hhautomatizacion/esclavochallenge/README.md

<br/>
<p align="center">
  
</p>
<br/>

# EsclavoChallenge

## Fecha
* 2013

## Descripcion del proyecto
* Esclavo para monitoreo de secadora challenge

## Herramientas utilizadas
* MikroBasic version 4.6
* PicKit2 version 2.61.00
* PCB Wizard Professional Edition version 3.50
	
## Modelos de PLC, etc.
* Tarjeta para secadora challenge H&H

## Autores
* <a href="http://www.github.com/emmanuel156">emmanuel156</a> 
* <a href="http://www.github.com/pedrohermon">pedrohermon</a> 
* <a href="http://www.github.com/genarohh">genarohh</a> 

## Comentarios
* Ninguno

## Contenido
* Carpeta de Diagramas
	* Diagramas del proyecto
		* Diagramas electricos
		* Diagramas de bloques
		* Dibujos
* Carpeta de Documentos
	* Documentos pensados para el usuario final
		* Manuales de usuario
		* Manuales de programacion
* Carpeta de Fotos
	* Fotos del proyecto antes, durante y despues del desarrollo del mismo
		* Fotos
		* Capturas de pantalla
* Carpeta de Historial
	* Documentacion del desarrollo del proyecto
		* Hojas de datos de componentes
		* Manuales de usuario de componentes
		* Documentacion de funciones, herramientas
* Carpeta de Programas
	* Programas de Computadora, PLC, etc. 
		* Codigos fuente.
		* Iconos e imagenes usados en los programas.
		* Archivos de configuracion de los programas.
		* Programas compilados.
* Carpeta de Pruebas
	* Pruebas preliminares del proyecto
		* Programas incompletos, o secciones de programas
		* Capturas de comunicacion
		* Modelos de componentes que se hayan probado

---
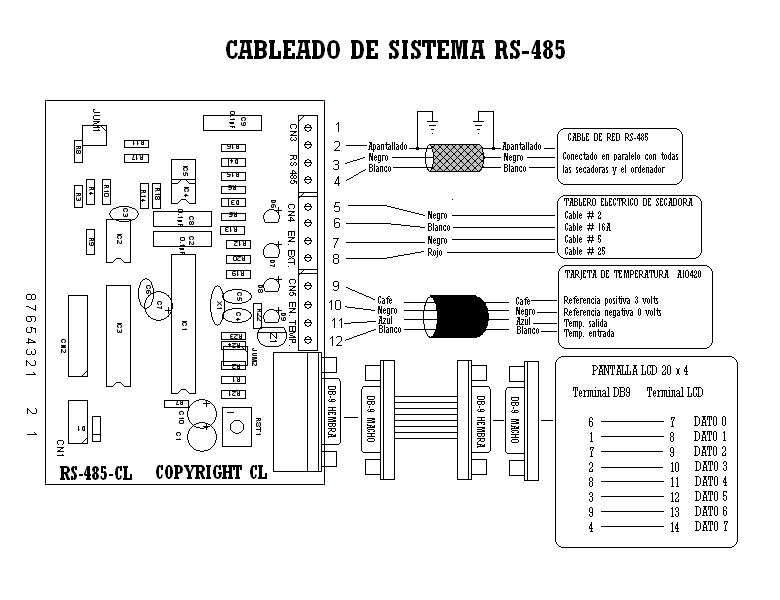
[picture p1: Diagramas/Cableado RS-485.bmp.jpg]
Cableado RS-485.bmp.jpg

---
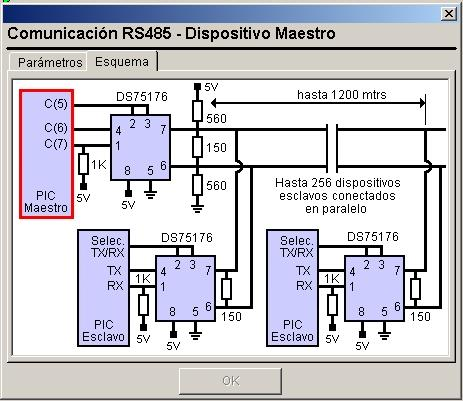
[picture p2: Diagramas/diagrama_niple_rs485.jpg]

---
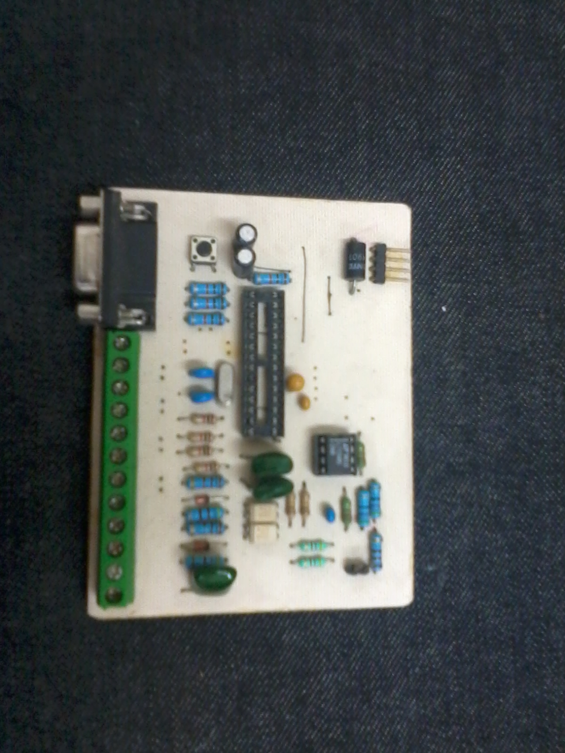
[picture p3: Fotos/2014-04-02 16.03.06.jpg]
2014-04-02 16.03.06.jpg

---
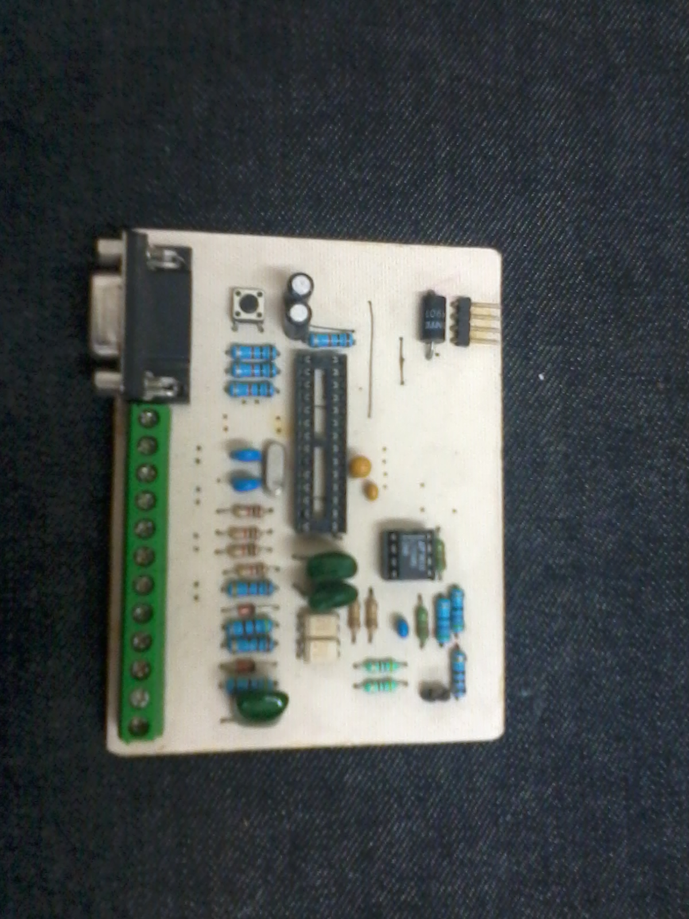
[picture p4: Fotos/2014-04-02 16.03.07.jpg]
2014-04-02 16.03.07.jpg

---
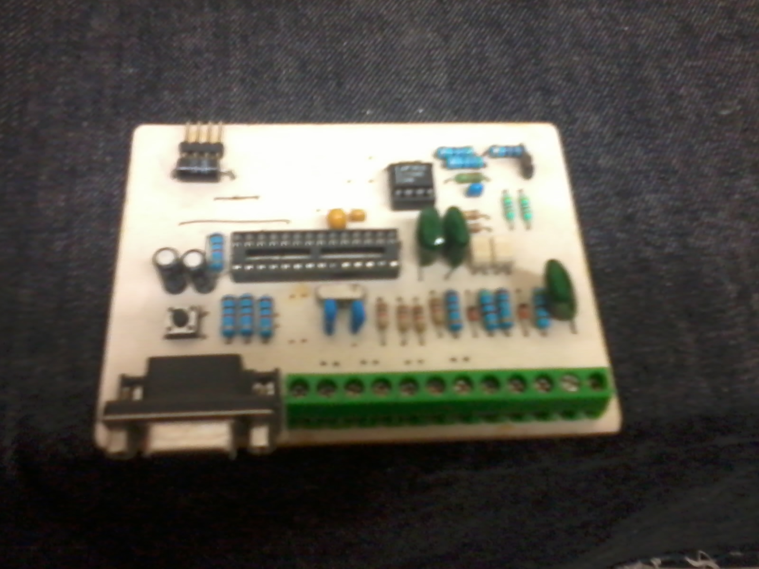
[picture p5: Fotos/2014-04-02 16.03.19.jpg]
2014-04-02 16.03.19.jpg

---
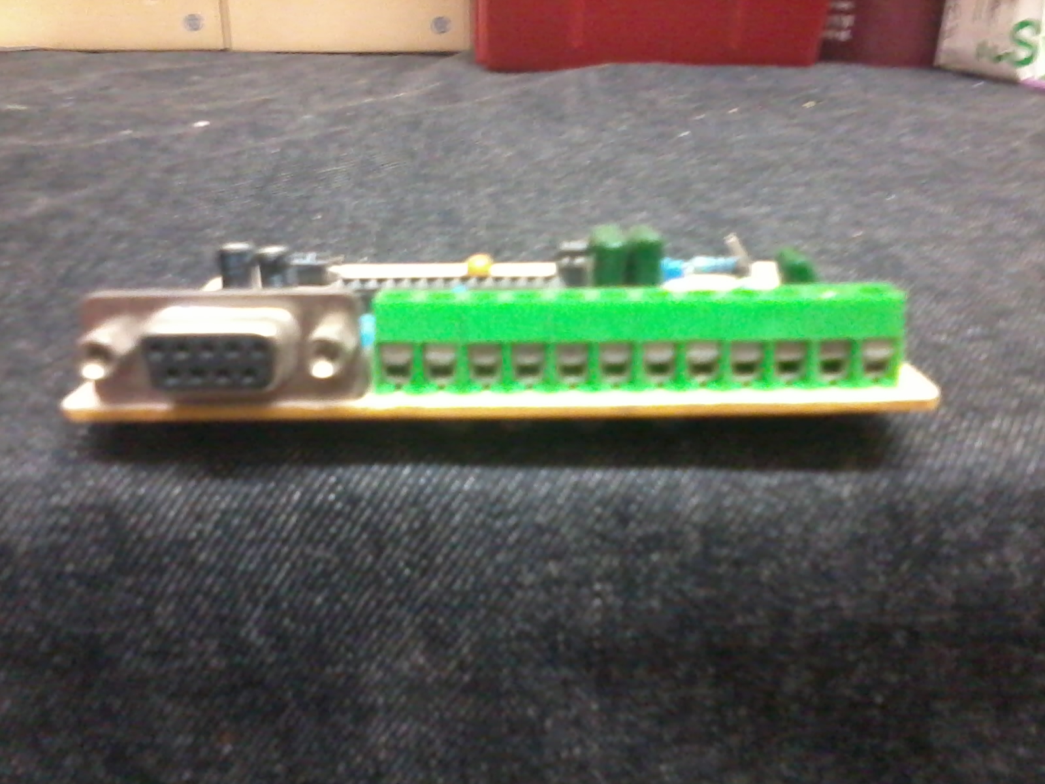
[picture p6: Fotos/2014-04-02 16.03.39.jpg]
2014-04-02 16.03.39.jpg

---
2014-04-02 16.03.40.jpg
---
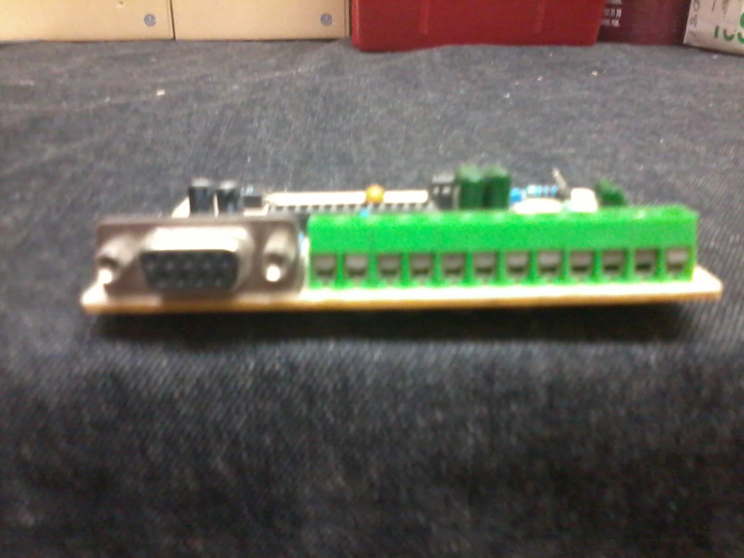
[picture p7: Fotos/2014-04-02 16.03.44.jpg]
2014-04-02 16.03.44.jpg

---
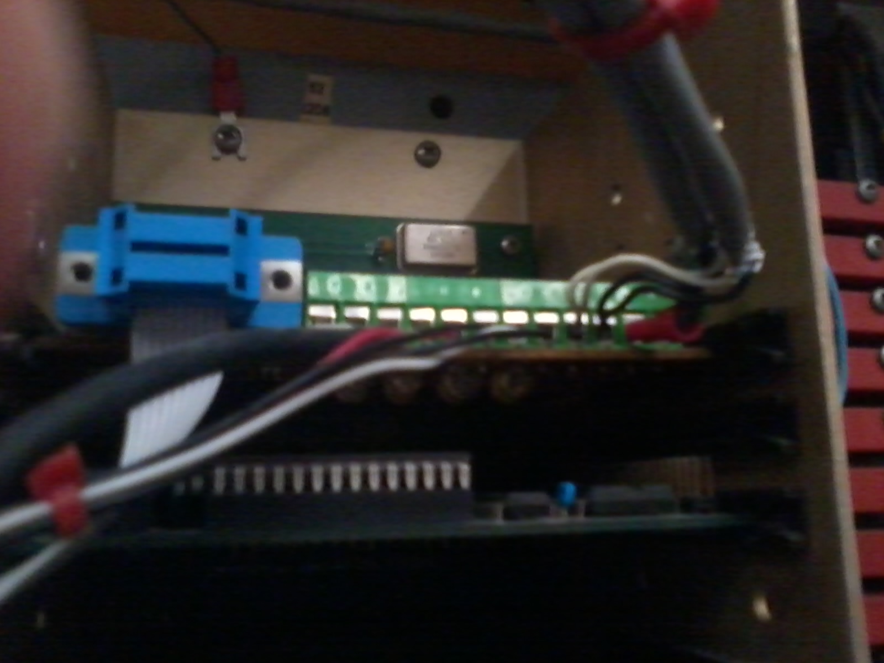
[picture p8: Fotos/2014-04-02 16.04.32.jpg]
2014-04-02 16.04.32.jpg

---
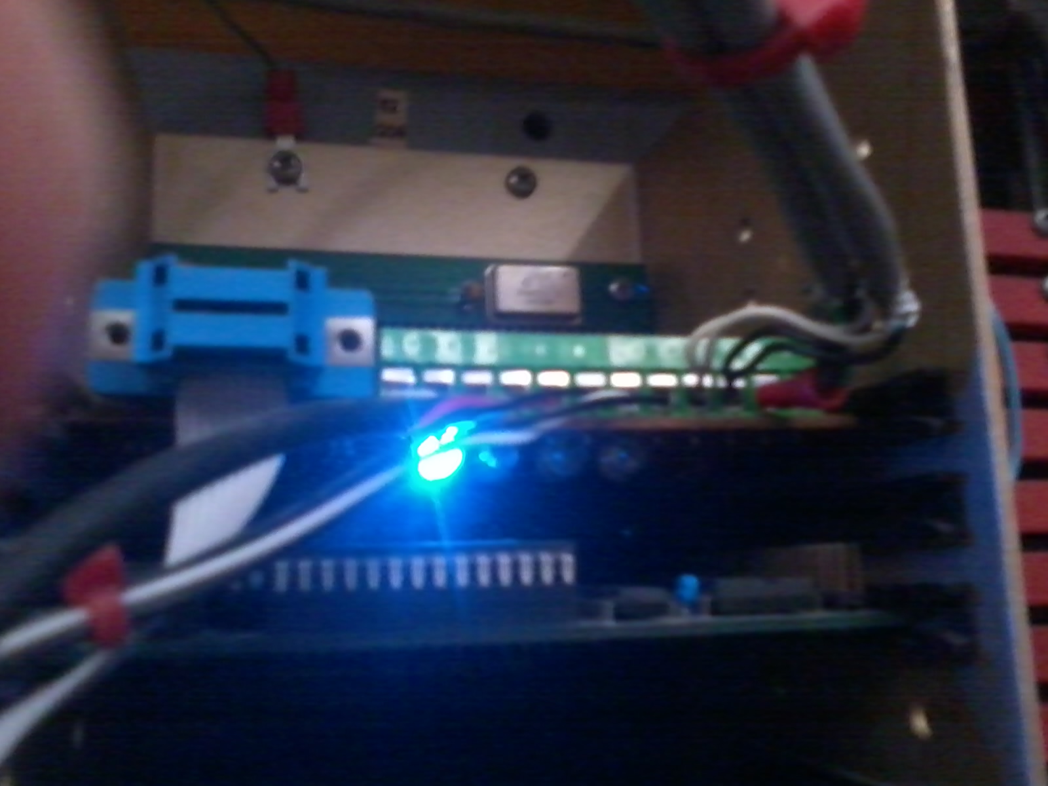
[picture p9: Fotos/2014-04-02 16.04.36.jpg]
2014-04-02 16.04.36.jpg

---
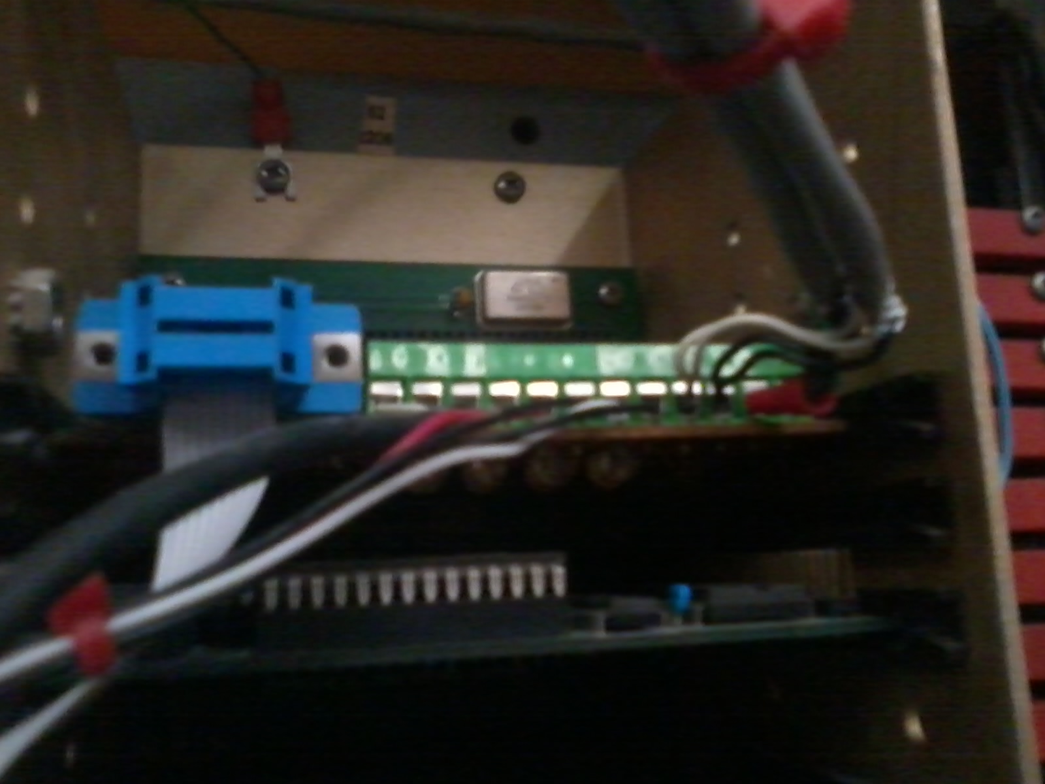
[picture p10: Fotos/2014-04-02 16.04.41.jpg]
2014-04-02 16.04.41.jpg

---
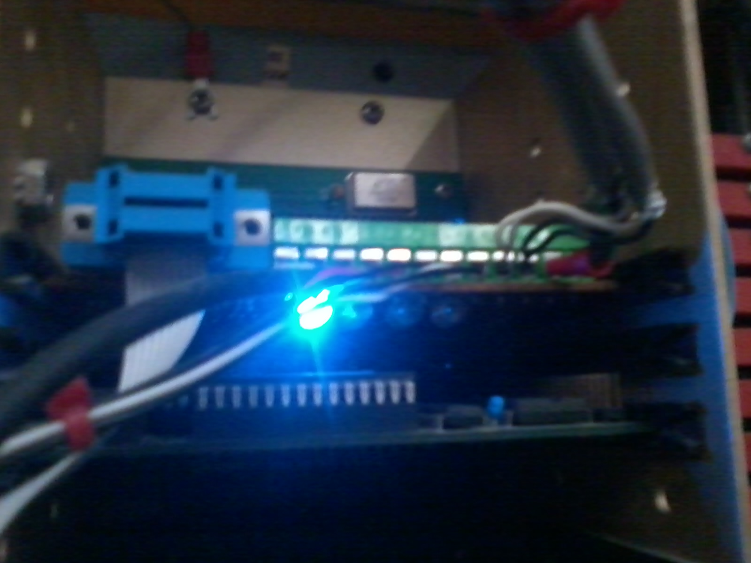
[picture p11: Fotos/2014-04-02 16.04.45.jpg]
2014-04-02 16.04.45.jpg

---
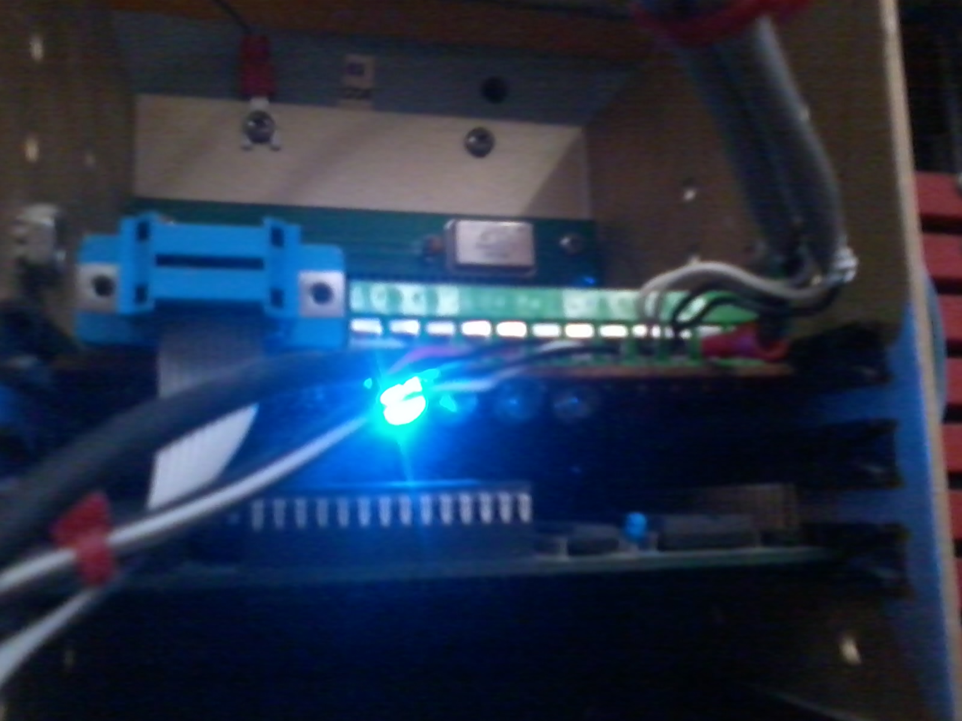
[picture p12: Fotos/2014-04-02 16.04.48.jpg]
2014-04-02 16.04.48.jpg

---
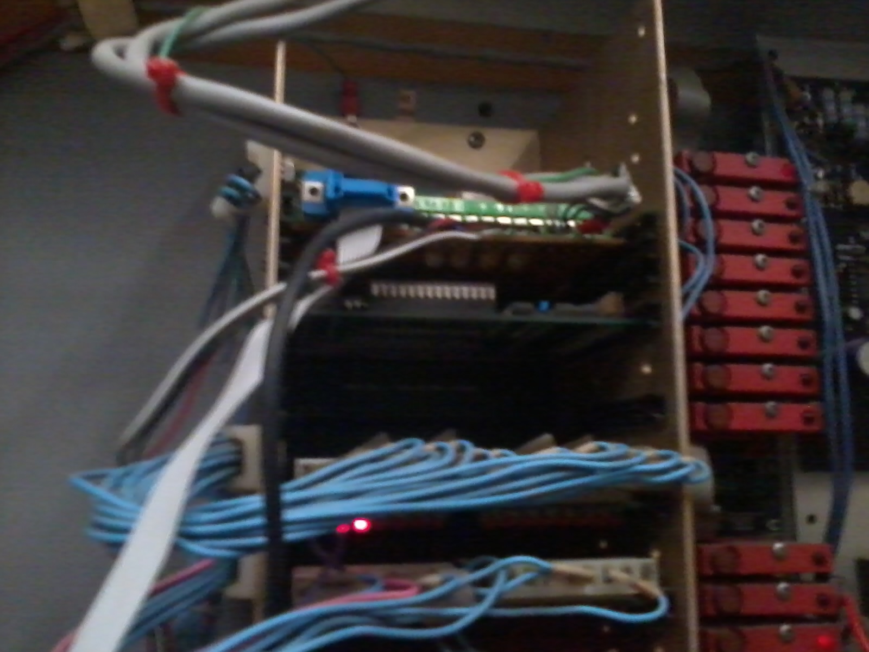
[picture p13: Fotos/2014-04-02 16.04.53.jpg]
2014-04-02 16.04.53.jpg

---
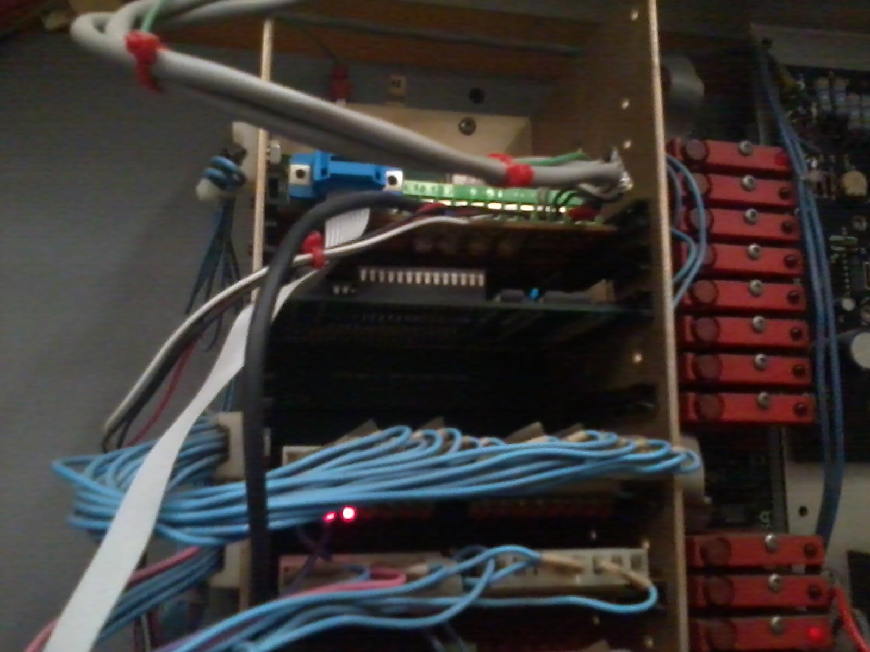
[picture p14: Fotos/2014-04-02 16.04.57.jpg]
2014-04-02 16.04.57.jpg

---
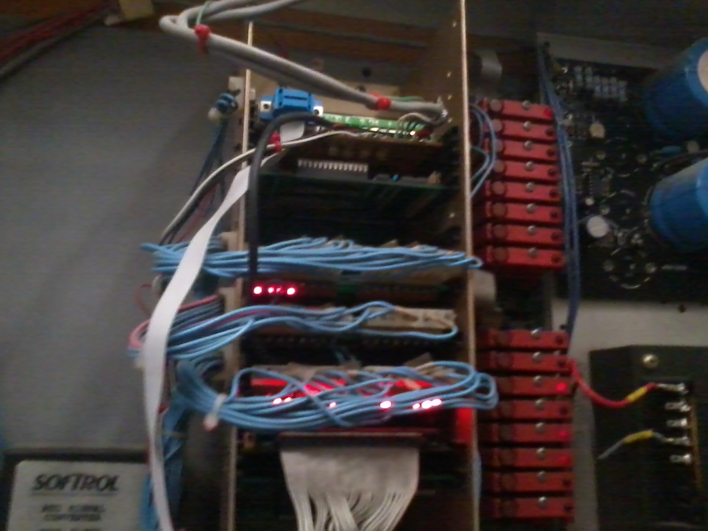
[picture p15: Fotos/2014-04-02 16.05.04.jpg]
2014-04-02 16.05.04.jpg

---
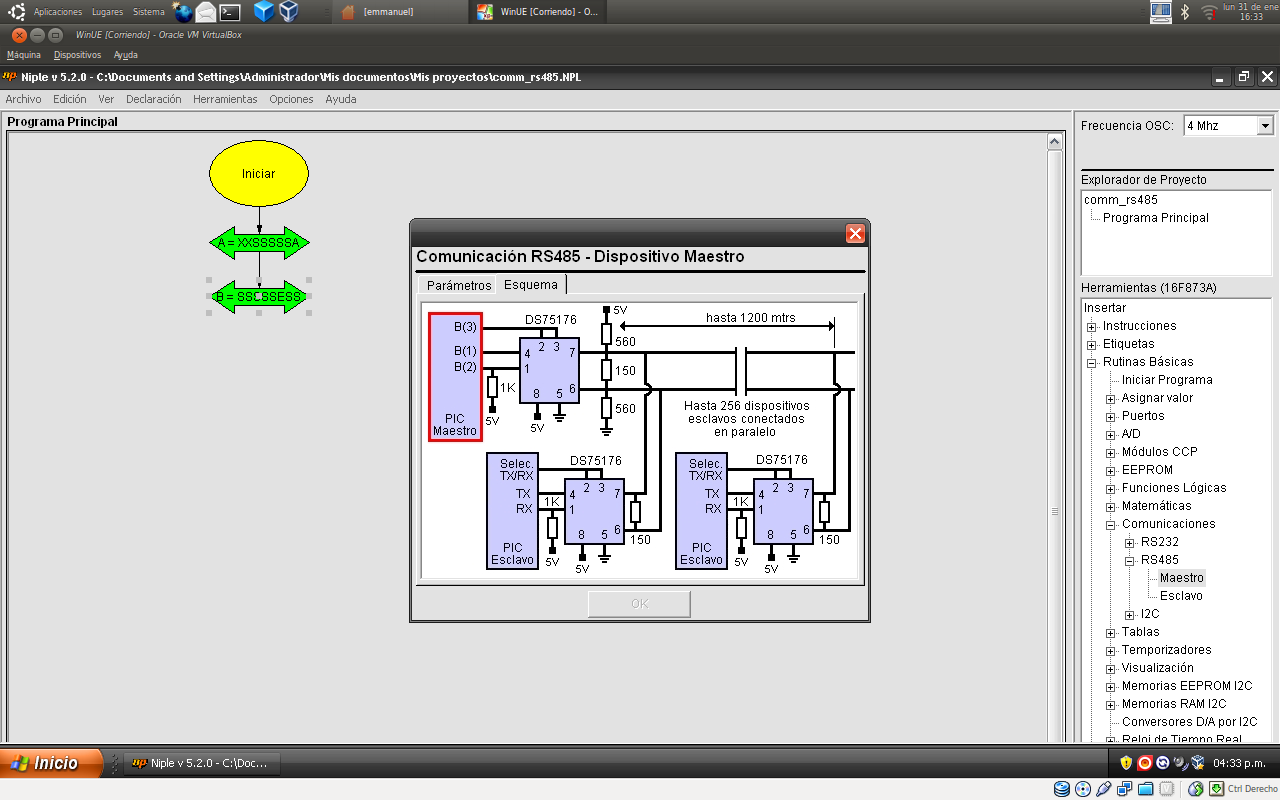
[picture p16: Fotos/Pantallazo.png]

---
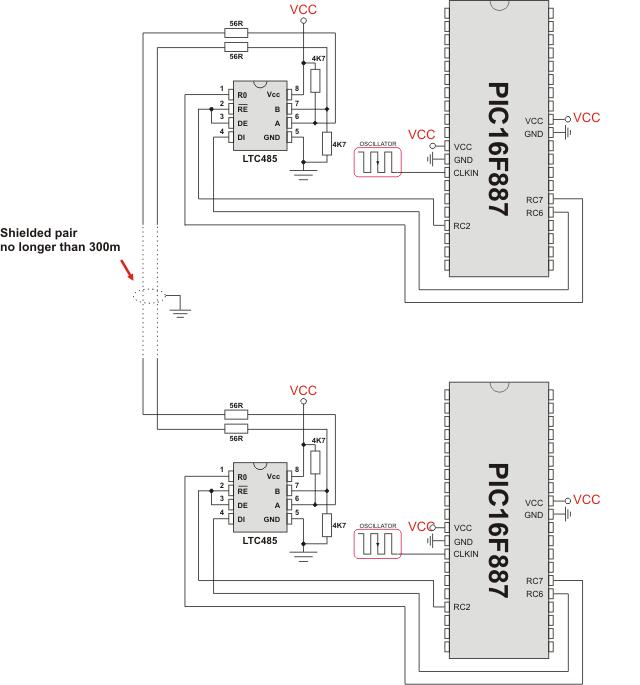
[picture p17: Historial/rs-485 2 pics.JPG]
rs-485 2 pics.JPG

---
