hhautomatizacion/esclavochallenge/Diagramas/README.md

<br/>
<p align="center">
  
</p>
<br/>

# Carpeta de Diagramas

## Diagramas del proyecto

* Diagramas electricos

* Diagramas de bloques

* Dibujos

---
Cableado RS-485.bmp.jpg
---

---
