hhautomatizacion/esclavochallenge/Historial/Componentes ESCLAVO.xlsx

Report (Esclavo.pcb)
 |  | Name | Quantity
 | IC1 | Microcontrolador PIC 16F873A | 1
 | IC2 | Interface Transceiver LTC485 | 1
 | IC3 | Flip flop tipo D MM74HC273 | 1
 | IC4, IC5 | Optoacoplador TLP521-1 | 2
 | C2,C8,C9 | 0.1µF Capacitor poliester metalizado | 3
 | C3 | 0.1µF Capacitor ceramico multilayer CML104M50 | 1
 | C6 | 0.01µF Capacitor ceramico multilayer CML103M50 | 1
 | C1, C10 | 1µF Electrolytic Capacitor | 2
 | C7 | 10µF Tantalio Capacitor | 1
 | C4,C5 | 22pF Capacitor ceramico | 2
 | R21 | 100 Resistor (1/4W) | 1
 | R14, R18 | 100K Resistor (1/4W) | 2
 | R1,R2,R7, 22, 23, 24 | 10K Resistor (1/4W) | 6
 | R8 | 120 Resistor (1/4W) | 1
 | R12,R13,R19,R20 | 1K Resistor (1/4W) | 4
 | R5 ,R15 | 2.7K Resistor (1/4W) | 2
 | R9, R10, R11, R17 | 4.7K Resistor (1/4W) | 4
 | R3, R4 | 47 Resistor (1/4W) | 2
 | R6, R16 | 470 Resistor (1/4W) | 2
 | X1 | Crystal Oscillator (4 MHz) | 1
 | D1 | Diodo bidereccional NTE4900 | 1
 | D3,D4 | 1N4148 Diode | 2
 | D6 | LED (Green) | 1
 | D7 | LED (Red) | 1
 | D8 | LED (Amber) | 1
 | D9 | LED (Blue) | 1
 | JUMP1, JUMP2 | Conector terminal simple 2.5mm (2 pines) | 2
 | CN1 | Conector terminal simple 2.5mm a 90° (4 pines) | 1
 | CN2 | Conector terminal simple 2.5mm a 90° (8 pines) | 1
 | CN6 | Conector terminal DB9 Hembra | 1
 | RST1 | SPST Switch | 1
 | CN3,CN4,CN5 | 4 pin Terminal Block | 3
