hhautomatizacion/esclavochallenge/Historial/Lista de componentes por PEDIR LB.xlsx

Report (EsclavoNN.pcb)
 |  | Name | PEDIR
 | IC1 | Circuito integrado TC7660PA | 10
 | IC2 | 0.1µF Capacitor ceramico multilayer CML104M50 | 20
 |  | Capacitor electrolitico 100 µF a 50 volts | 10
 | C2,C8,C9 | Diodo 1N4007 | 20
 | C3 | Diodo 1N4148 | 20
 | C6 | Diodo LED ultrabrillante (verde) 3mm. | 15
 | C1, C10 | Diodo LED ultrabrillante (rojo) 3mm. | 10
 | C7
 | C4,C5
 |  | Diodo LED ultrabrillante (Blanco) 3mm. | 10
 | R1,R2,R7, 22, 23, 24 | Micro switch de presión (Push), de 12 Vcc, 50 mA, 4 terminales, normalmente abierto (NA). | 10
 | R12,R13,R19,R20 | Terminal grande con 3 tornillos, para circuito impreso, de 8 amperes | 20
 | R9, R10, R11, R17 | Bases para IC de 8 pines, tipo DIP (7.6 mm) | 10
 | R3, R4 | Bases para IC de 28 pines, tipo DIP (7.6 mm) | 10
 |  | Kit programador pic usb master Modelo: kit Z1 + 16f887 | 1
 | X1
 | D1
 | D3,D4
 | D6
 | D7
 | D8
 | D9
 | JUMP1, JUMP2
 | CN1
 | CN2
 | CN6
 | RST1
 | CN3,CN4,CN5
