hhautomatizacion/esclavochallenge/Historial/Lista de componentes por PEDIR.xlsx

Report (EsclavoNN.pcb)
 |  | Name | PEDIR
 | IC1 | Microcontrolador PIC 16F873A | 10
 | IC2 | Interface Transceiver LTC485 | 10
 | IC3
 | IC4, IC5 | Optoacoplador TLP521-1 | 30
 | C2,C8,C9 | 0.1µF Capacitor poliester metalizado a 50 volts | 30
 | C3 | 0.1µF Capacitor ceramico multilayer CML104M50 | 20
 | C6 | 0.01µF Capacitor ceramico multilayer CML103M50 | 20
 | C1, C10 | 1µF Electrolytic Capacitor | 20
 | C7
 | C4,C5 | 22pF Capacitor ceramico a 50 volts | 20
 | R21 | 100 Resistor (1/4W) | 10
 | R14, R18
 | R1,R2,R7, 22, 23, 24 | 10K Resistor (1/4W) | 20
 | R8 | 120 Resistor (1/4W) | 10
 | R12,R13,R19,R20 | 1K Resistor (1/4W) | 60
 | R5 ,R15 | 2.7K Resistor (1/4W) | 20
 | R9, R10, R11, R17
 | R3, R4 | 47 Resistor (1/4W) | 20
 | R6, R16 | 470 Resistor (1/4W) | 30
 | X1 | Crystal Oscillator (4 MHz) mini | 20
 | D1 | Diodo bidereccional NTE4900
 | D3,D4 | 1N4148 Diode | 10
 | D6 | LED (verde) 3mm. | 15
 | D7 | LED (rojo) 3mm. | 15
 | D8 | LED (Ambar) 3mm. | 15
 | D9 | LED (azul) 3mm. | 15
 |  | LED (Blanco) 3mm. | 15
 | JUMP1, JUMP2
 | CN1
 | CN2
 | CN6
 | RST1 | Conector terminal tira sencilla de 36 pines 2.5mm a 90° ,para circuito impreso | 10
 |  | Conector terminal DB9 Hembra (para circuito impreso) | 5
 | CN3,CN4,CN5 | Conector terminal DB9 Hembra (para cable plano) | 10
 |  | Conector terminal DB9 macho (para cable plano) | 20
 |  | Micro switch de presión (Push), de 12 Vcc, 50 mA, 4 terminales, normalmente abierto (NA). | 15
 |  | Terminal grande con 3 tornillos, para circuito impreso, de 8 amperes | 20
 |  | Bases para IC de 8 pines, tipo DIP (7.6 mm) | 20
 |  | Bases para IC de 28 pines, tipo DIP (7.6 mm) | 15
