hhautomatizacion/esclavochallenge/(list of files, drawings)

Other design files:
Diagramas/Circuito Impreso Esclavo.pcb
Diagramas/Diagrama electronico Esclavo.pcb
