hhautomatizacion/esclavochallenge/Programas/esclavo.asm

_LimpiarLeds:

;esclavo.mbas,41 :: 		sub procedure LimpiarLeds
;esclavo.mbas,42 :: 		LimpiaPerro=0
	CLRF       _LimpiaPerro+0
;esclavo.mbas,43 :: 		if testbit(STATUS,4) then
	CLRF       R0+0
	BTFSS      STATUS+0, 4
	GOTO       L__LimpiarLeds4
	MOVLW      1
	MOVWF      R0+0
L__LimpiarLeds4:
	MOVF       R0+0, 0
	BTFSC      STATUS+0, 2
	GOTO       L__LimpiarLeds2
;esclavo.mbas,44 :: 		porta.4=0
	BCF        PORTA+0, 4
	GOTO       L__LimpiarLeds3
;esclavo.mbas,45 :: 		else
L__LimpiarLeds2:
;esclavo.mbas,46 :: 		clrwdt
	CLRWDT
;esclavo.mbas,47 :: 		porta.4=1
	BSF        PORTA+0, 4
;esclavo.mbas,48 :: 		porta.5=1
	BSF        PORTA+0, 5
;esclavo.mbas,49 :: 		portc.0=1
	BSF        PORTC+0, 0
;esclavo.mbas,50 :: 		portc.1=1
	BSF        PORTC+0, 1
;esclavo.mbas,51 :: 		end if
L__LimpiarLeds3:
;esclavo.mbas,53 :: 		end sub
	RETURN
; end of _LimpiarLeds

_Leer_Caracter:

;esclavo.mbas,54 :: 		sub procedure Leer_Caracter
;esclavo.mbas,55 :: 		TimeOut4=0
	CLRF       _TimeOut4+0
;esclavo.mbas,56 :: 		TimeOut3=0
	CLRF       _TimeOut3+0
;esclavo.mbas,57 :: 		do
L__Leer_Caracter6:
;esclavo.mbas,58 :: 		do
L__Leer_Caracter11:
;esclavo.mbas,59 :: 		do
L__Leer_Caracter16:
;esclavo.mbas,60 :: 		delay_us(300)
	MOVLW      99
	MOVWF      R13+0
L__Leer_Caracter21:
	DECFSZ     R13+0, 1
	GOTO       L__Leer_Caracter21
	NOP
	NOP
;esclavo.mbas,61 :: 		caracter=portb
	MOVF       PORTB+0, 0
	MOVWF      _Caracter+0
;esclavo.mbas,62 :: 		inc(timeout4)
	INCF       _TimeOut4+0, 1
;esclavo.mbas,63 :: 		if TimeOut4 > 200 then
	MOVF       _TimeOut4+0, 0
	SUBLW      200
	BTFSC      STATUS+0, 0
	GOTO       L__Leer_Caracter23
;esclavo.mbas,64 :: 		TimeOut4=0
	CLRF       _TimeOut4+0
;esclavo.mbas,65 :: 		inc(timeout3)
	INCF       _TimeOut3+0, 1
;esclavo.mbas,66 :: 		if TimeOut3 > 5 then
	MOVF       _TimeOut3+0, 0
	SUBLW      5
	BTFSC      STATUS+0, 0
	GOTO       L__Leer_Caracter26
;esclavo.mbas,67 :: 		Caracter=32
	MOVLW      32
	MOVWF      _Caracter+0
;esclavo.mbas,68 :: 		exit
	GOTO       L_end__Leer_Caracter
L__Leer_Caracter26:
;esclavo.mbas,69 :: 		end if
L__Leer_Caracter23:
;esclavo.mbas,71 :: 		if Caracter=0 then
	MOVF       _Caracter+0, 0
	XORLW      0
	BTFSS      STATUS+0, 2
	GOTO       L__Leer_Caracter29
;esclavo.mbas,72 :: 		Ant_Caracter=0
	CLRF       _Ant_Caracter+0
L__Leer_Caracter29:
;esclavo.mbas,74 :: 		loop until Caracter <> 0
	MOVF       _Caracter+0, 0
	XORLW      0
	BTFSS      STATUS+0, 2
	GOTO       L__Leer_Caracter19
	GOTO       L__Leer_Caracter16
L__Leer_Caracter19:
;esclavo.mbas,75 :: 		if Caracter=255 then
	MOVF       _Caracter+0, 0
	XORLW      255
	BTFSS      STATUS+0, 2
	GOTO       L__Leer_Caracter32
;esclavo.mbas,76 :: 		Ant_Caracter=0
	CLRF       _Ant_Caracter+0
L__Leer_Caracter32:
;esclavo.mbas,78 :: 		loop until Caracter <> 255
	MOVF       _Caracter+0, 0
	XORLW      255
	BTFSS      STATUS+0, 2
	GOTO       L__Leer_Caracter14
	GOTO       L__Leer_Caracter11
L__Leer_Caracter14:
;esclavo.mbas,79 :: 		loop until Caracter <> ant_caracter
	MOVF       _Caracter+0, 0
	XORWF      _Ant_Caracter+0, 0
	BTFSS      STATUS+0, 2
	GOTO       L__Leer_Caracter9
	GOTO       L__Leer_Caracter6
L__Leer_Caracter9:
;esclavo.mbas,80 :: 		Ant_Caracter=caracter
	MOVF       _Caracter+0, 0
	MOVWF      _Ant_Caracter+0
;esclavo.mbas,81 :: 		end sub
L_end__Leer_Caracter:
	RETURN
; end of _Leer_Caracter

_Inicio_LCD:

;esclavo.mbas,82 :: 		sub procedure Inicio_LCD
;esclavo.mbas,83 :: 		timeout4=0
	CLRF       _TimeOut4+0
;esclavo.mbas,84 :: 		TimeOut3=0
	CLRF       _TimeOut3+0
;esclavo.mbas,85 :: 		InicioLCD=false
	CLRF       _InicioLCD+0
;esclavo.mbas,86 :: 		do
L__Inicio_LCD35:
;esclavo.mbas,87 :: 		Ant_Caracter=caracter
	MOVF       _Caracter+0, 0
	MOVWF      _Ant_Caracter+0
;esclavo.mbas,88 :: 		delay_us(300)
	MOVLW      99
	MOVWF      R13+0
L__Inicio_LCD40:
	DECFSZ     R13+0, 1
	GOTO       L__Inicio_LCD40
	NOP
	NOP
;esclavo.mbas,89 :: 		Caracter=portb
	MOVF       PORTB+0, 0
	MOVWF      _Caracter+0
;esclavo.mbas,90 :: 		inc(timeout4)
	INCF       _TimeOut4+0, 1
;esclavo.mbas,91 :: 		if TimeOut4 > 200 then
	MOVF       _TimeOut4+0, 0
	SUBLW      200
	BTFSC      STATUS+0, 0
	GOTO       L__Inicio_LCD42
;esclavo.mbas,92 :: 		TimeOut4=0
	CLRF       _TimeOut4+0
;esclavo.mbas,93 :: 		inc(timeout3)
	INCF       _TimeOut3+0, 1
;esclavo.mbas,94 :: 		if TimeOut3 > 30 then
	MOVF       _TimeOut3+0, 0
	SUBLW      30
	BTFSC      STATUS+0, 0
	GOTO       L__Inicio_LCD45
;esclavo.mbas,95 :: 		exit
	GOTO       L_end__Inicio_LCD
L__Inicio_LCD45:
;esclavo.mbas,96 :: 		end if
L__Inicio_LCD42:
;esclavo.mbas,98 :: 		loop until (Caracter=lcdstart1) and (Ant_Caracter = LcdStart2)
	MOVF       _Caracter+0, 0
	XORWF      _LcdStart1+0, 0
	MOVLW      255
	BTFSS      STATUS+0, 2
	MOVLW      0
	MOVWF      R1+0
	MOVF       _Ant_Caracter+0, 0
	XORWF      _LcdStart2+0, 0
	MOVLW      255
	BTFSS      STATUS+0, 2
	MOVLW      0
	MOVWF      R0+0
	MOVF       R1+0, 0
	ANDWF      R0+0, 1
	BTFSS      STATUS+0, 2
	GOTO       L__Inicio_LCD38
	GOTO       L__Inicio_LCD35
L__Inicio_LCD38:
;esclavo.mbas,99 :: 		if (Caracter=lcdstart1) and (Ant_Caracter = LcdStart2) then
	MOVF       _Caracter+0, 0
	XORWF      _LcdStart1+0, 0
	MOVLW      255
	BTFSS      STATUS+0, 2
	MOVLW      0
	MOVWF      R1+0
	MOVF       _Ant_Caracter+0, 0
	XORWF      _LcdStart2+0, 0
	MOVLW      255
	BTFSS      STATUS+0, 2
	MOVLW      0
	MOVWF      R0+0
	MOVF       R1+0, 0
	ANDWF      R0+0, 1
	BTFSC      STATUS+0, 2
	GOTO       L__Inicio_LCD48
;esclavo.mbas,100 :: 		InicioLCD=true
	MOVLW      255
	MOVWF      _InicioLCD+0
;esclavo.mbas,101 :: 		Ant_Caracter=128
	MOVLW      128
	MOVWF      _Ant_Caracter+0
L__Inicio_LCD48:
;esclavo.mbas,103 :: 		end sub
L_end__Inicio_LCD:
	RETURN
; end of _Inicio_LCD

_Leer_LCD:

;esclavo.mbas,104 :: 		sub procedure Leer_LCD
;esclavo.mbas,107 :: 		Inicio_LCD
	CALL       _Inicio_LCD+0
;esclavo.mbas,109 :: 		if InicioLCD then
	MOVF       _InicioLCD+0, 0
	BTFSC      STATUS+0, 2
	GOTO       L__Leer_LCD52
;esclavo.mbas,111 :: 		contador=7
	MOVLW      7
	MOVWF      _Contador+0
;esclavo.mbas,112 :: 		do
L__Leer_LCD54:
;esclavo.mbas,113 :: 		Leer_Caracter
	CALL       _Leer_Caracter+0
;esclavo.mbas,115 :: 		case 65,66,67,68,69,70,71,72,73,74,75,76,77,78,79,80,81,82,83,84,85,86,87,88,89,90
	MOVF       _Caracter+0, 0
	XORLW      65
	BTFSS      STATUS+0, 2
	GOTO       L__Leer_LCD62
	GOTO       L__Leer_LCD60
L__Leer_LCD62:
	MOVF       _Caracter+0, 0
	XORLW      66
	BTFSS      STATUS+0, 2
	GOTO       L__Leer_LCD63
	GOTO       L__Leer_LCD60
L__Leer_LCD63:
	MOVF       _Caracter+0, 0
	XORLW      67
	BTFSS      STATUS+0, 2
	GOTO       L__Leer_LCD64
	GOTO       L__Leer_LCD60
L__Leer_LCD64:
	MOVF       _Caracter+0, 0
	XORLW      68
	BTFSS      STATUS+0, 2
	GOTO       L__Leer_LCD65
	GOTO       L__Leer_LCD60
L__Leer_LCD65:
	MOVF       _Caracter+0, 0
	XORLW      69
	BTFSS      STATUS+0, 2
	GOTO       L__Leer_LCD66
	GOTO       L__Leer_LCD60
L__Leer_LCD66:
	MOVF       _Caracter+0, 0
	XORLW      70
	BTFSS      STATUS+0, 2
	GOTO       L__Leer_LCD67
	GOTO       L__Leer_LCD60
L__Leer_LCD67:
	MOVF       _Caracter+0, 0
	XORLW      71
	BTFSS      STATUS+0, 2
	GOTO       L__Leer_LCD68
	GOTO       L__Leer_LCD60
L__Leer_LCD68:
	MOVF       _Caracter+0, 0
	XORLW      72
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
L__Leer_LCD59:
;esclavo.mbas,129 :: 		loop until contador > 91
	MOVF       _Contador+0, 0
	SUBLW      91
	BTFSS      STATUS+0, 0
	GOTO       L__Leer_LCD57
	GOTO       L__Leer_LCD54
L__Leer_LCD57:
L__Leer_LCD52:
;esclavo.mbas,132 :: 		end sub
	RETURN
; end of _Leer_LCD

_CalcularCRC:

;esclavo.mbas,133 :: 		sub procedure CalcularCRC()
;esclavo.mbas,134 :: 		crc=65535
	MOVLW      255
	MOVWF      _CRC+0
	MOVLW      255
	MOVWF      _CRC+1
;esclavo.mbas,135 :: 		for iter=0 to Longitud - 1
	CLRF       _Iter+0
L__CalcularCRC141:
	DECF       _Longitud+0, 0
	MOVWF      R2+0
	MOVF       _Iter+0, 0
	SUBWF      R2+0, 0
	BTFSS      STATUS+0, 0
	GOTO       L__CalcularCRC145
;esclavo.mbas,136 :: 		crc=crc xor mensaje[iter]
	MOVF       _Iter+0, 0
	ADDLW      _Mensaje+0
	MOVWF      FSR
	MOVF       INDF+0, 0
	XORWF      _CRC+0, 1
	MOVLW      0
	XORWF      _CRC+1, 1
;esclavo.mbas,137 :: 		for bites= 1 to 8
	MOVLW      1
	MOVWF      _bites+0
L__CalcularCRC147:
;esclavo.mbas,138 :: 		if crc mod 2 then
	BTFSS      _CRC+0, 0
	GOTO       L__CalcularCRC152
;esclavo.mbas,139 :: 		crc=(crc / 2) xor 40961
	RRF        _CRC+1, 1
	RRF        _CRC+0, 1
	BCF        _CRC+1, 7
	MOVLW      1
	XORWF      _CRC+0, 1
	MOVLW      160
	XORWF      _CRC+1, 1
	GOTO       L__CalcularCRC153
;esclavo.mbas,140 :: 		else
L__CalcularCRC152:
;esclavo.mbas,141 :: 		crc=crc / 2
	RRF        _CRC+1, 1
	RRF        _CRC+0, 1
	BCF        _CRC+1, 7
;esclavo.mbas,142 :: 		end if
L__CalcularCRC153:
;esclavo.mbas,143 :: 		next bites
	MOVF       _bites+0, 0
	XORLW      8
	BTFSC      STATUS+0, 2
	GOTO       L__CalcularCRC150
	INCF       _bites+0, 1
	GOTO       L__CalcularCRC147
L__CalcularCRC150:
;esclavo.mbas,144 :: 		next iter
	MOVF       _Iter+0, 0
	XORWF      R2+0, 0
	BTFSC      STATUS+0, 2
	GOTO       L__CalcularCRC145
	INCF       _Iter+0, 1
	GOTO       L__CalcularCRC141
L__CalcularCRC145:
;esclavo.mbas,145 :: 		CRC_h=hi(crc)
	MOVF       _CRC+1, 0
	MOVWF      _CRC_H+0
;esclavo.mbas,146 :: 		CRC_l=lo(crc)
	MOVF       _CRC+0, 0
	MOVWF      _CRC_L+0
;esclavo.mbas,147 :: 		end sub
	RETURN
; end of _CalcularCRC

_interrupt:
	MOVWF      R15+0
	SWAPF      STATUS+0, 0
	CLRF       STATUS+0
	MOVWF      ___saveSTATUS+0
	MOVF       PCLATH+0, 0
	MOVWF      ___savePCLATH+0
	CLRF       PCLATH+0

;esclavo.mbas,149 :: 		sub procedure interrupt()
;esclavo.mbas,150 :: 		GIE_bit = 0
	BCF        GIE_bit+0, 7
;esclavo.mbas,151 :: 		if uart1_data_ready=1 then
	CALL       _UART1_Data_Ready+0
	MOVF       R0+0, 0
	XORLW      1
	BTFSS      STATUS+0, 2
	GOTO       L__interrupt156
;esclavo.mbas,152 :: 		Recivido=uart1_read
	CALL       _UART1_Read+0
	MOVF       R0+0, 0
	MOVWF      _Recivido+0
;esclavo.mbas,153 :: 		llamada[0]=llamada[1]
	MOVF       _Llamada+1, 0
	MOVWF      _Llamada+0
;esclavo.mbas,154 :: 		llamada[1]=llamada[2]
	MOVF       _Llamada+2, 0
	MOVWF      _Llamada+1
;esclavo.mbas,155 :: 		llamada[2]=llamada[3]
	MOVF       _Llamada+3, 0
	MOVWF      _Llamada+2
;esclavo.mbas,156 :: 		llamada[3]=recivido
	MOVF       R0+0, 0
	MOVWF      _Llamada+3
;esclavo.mbas,157 :: 		if Llamada[1]=esclavo then
	MOVF       _Llamada+1, 0
	XORWF      _Esclavo+0, 0
	BTFSS      STATUS+0, 2
	GOTO       L__interrupt159
;esclavo.mbas,158 :: 		mensaje[0]=llamada[0]
	MOVF       _Llamada+0, 0
	MOVWF      _Mensaje+0
;esclavo.mbas,159 :: 		Mensaje[1]=llamada[1]
	MOVF       _Llamada+1, 0
	MOVWF      _Mensaje+1
;esclavo.mbas,160 :: 		Longitud=2
	MOVLW      2
	MOVWF      _Longitud+0
;esclavo.mbas,161 :: 		CalcularCRC
	CALL       _CalcularCRC+0
;esclavo.mbas,162 :: 		CRC_ok=false
	CLRF       _CRC_ok+0
;esclavo.mbas,163 :: 		if Llamada[3]=crc_h then
	MOVF       _Llamada+3, 0
	XORWF      _CRC_H+0, 0
	BTFSS      STATUS+0, 2
	GOTO       L__interrupt162
;esclavo.mbas,164 :: 		if Llamada[2]=crc_l then
	MOVF       _Llamada+2, 0
	XORWF      _CRC_L+0, 0
	BTFSS      STATUS+0, 2
	GOTO       L__interrupt165
;esclavo.mbas,165 :: 		if Llamada[0]=15 then
	MOVF       _Llamada+0, 0
	XORLW      15
	BTFSS      STATUS+0, 2
	GOTO       L__interrupt168
;esclavo.mbas,166 :: 		portc.0=0                ' encender led rojo
	BCF        PORTC+0, 0
;esclavo.mbas,167 :: 		portc.1=1                ' apagar led verde
	BSF        PORTC+0, 1
L__interrupt168:
;esclavo.mbas,169 :: 		if Llamada[0]=6 then
	MOVF       _Llamada+0, 0
	XORLW      6
	BTFSS      STATUS+0, 2
	GOTO       L__interrupt171
;esclavo.mbas,170 :: 		portc.0=1                ' apagar el led rojo
	BSF        PORTC+0, 0
;esclavo.mbas,171 :: 		portc.1=0                ' encender led verde
	BCF        PORTC+0, 1
;esclavo.mbas,172 :: 		if InicioLCD then
	MOVF       _InicioLCD+0, 0
	BTFSC      STATUS+0, 2
	GOTO       L__interrupt174
;esclavo.mbas,173 :: 		LimpiaPerro=0
	CLRF       _LimpiaPerro+0
L__interrupt174:
;esclavo.mbas,175 :: 		porta.4=1
	BSF        PORTA+0, 4
L__interrupt171:
;esclavo.mbas,177 :: 		if Llamada[0]=5 then
	MOVF       _Llamada+0, 0
	XORLW      5
	BTFSS      STATUS+0, 2
	GOTO       L__interrupt177
;esclavo.mbas,178 :: 		clrwdt
	CLRWDT
;esclavo.mbas,179 :: 		CRC_ok=true
	MOVLW      255
	MOVWF      _CRC_ok+0
;esclavo.mbas,180 :: 		porta.5=0                ' encender led ambar
	BCF        PORTA+0, 5
;esclavo.mbas,181 :: 		portc.0=1                ' apagar el led rojo
	BSF        PORTC+0, 0
;esclavo.mbas,182 :: 		portc.1=1                ' apagar led verde
	BSF        PORTC+0, 1
;esclavo.mbas,183 :: 		Suma=0
	CLRF       _Suma+0
	CLRF       _Suma+1
;esclavo.mbas,184 :: 		for Iter=1 to lect_prom
	MOVLW      1
	MOVWF      _Iter+0
L__interrupt179:
	MOVF       _Iter+0, 0
	SUBWF      _Lect_prom+0, 0
	BTFSS      STATUS+0, 0
	GOTO       L__interrupt183
;esclavo.mbas,185 :: 		adc_init
	CALL       _ADC_Init+0
;esclavo.mbas,186 :: 		Temp = adc_read(0)
	CLRF       FARG_ADC_Read_channel+0
	CALL       _ADC_Read+0
	MOVF       R0+0, 0
	MOVWF      _Temp+0
	MOVF       R0+1, 0
	MOVWF      _Temp+1
;esclavo.mbas,187 :: 		Suma=suma+temp
	MOVF       R0+0, 0
	ADDWF      _Suma+0, 1
	MOVF       R0+1, 0
	BTFSC      STATUS+0, 0
	ADDLW      1
	ADDWF      _Suma+1, 1
;esclavo.mbas,188 :: 		next Iter
	MOVF       _Iter+0, 0
	XORWF      _Lect_prom+0, 0
	BTFSC      STATUS+0, 2
	GOTO       L__interrupt183
	INCF       _Iter+0, 1
	GOTO       L__interrupt179
L__interrupt183:
;esclavo.mbas,189 :: 		Temp=suma/lect_prom
	MOVF       _Lect_prom+0, 0
	MOVWF      R4+0
	CLRF       R4+1
	MOVF       _Suma+0, 0
	MOVWF      R0+0
	MOVF       _Suma+1, 0
	MOVWF      R0+1
	CALL       _Div_16x16_U+0
	MOVF       R0+0, 0
	MOVWF      _Temp+0
	MOVF       R0+1, 0
	MOVWF      _Temp+1
;esclavo.mbas,190 :: 		Temp1_H=hi(temp)
	MOVF       _Temp+1, 0
	MOVWF      _Temp1_H+0
;esclavo.mbas,191 :: 		Temp1_L=lo(temp)
	MOVF       _Temp+0, 0
	MOVWF      _Temp1_L+0
;esclavo.mbas,192 :: 		Suma=0
	CLRF       _Suma+0
	CLRF       _Suma+1
;esclavo.mbas,193 :: 		for Iter=1 to Lect_prom
	MOVLW      1
	MOVWF      _Iter+0
L__interrupt184:
	MOVF       _Iter+0, 0
	SUBWF      _Lect_prom+0, 0
	BTFSS      STATUS+0, 0
	GOTO       L__interrupt188
;esclavo.mbas,194 :: 		adc_init
	CALL       _ADC_Init+0
;esclavo.mbas,195 :: 		Temp=adc_read(1)
	MOVLW      1
	MOVWF      FARG_ADC_Read_channel+0
	CALL       _ADC_Read+0
	MOVF       R0+0, 0
	MOVWF      _Temp+0
	MOVF       R0+1, 0
	MOVWF      _Temp+1
;esclavo.mbas,196 :: 		Suma=suma+temp
	MOVF       R0+0, 0
	ADDWF      _Suma+0, 1
	MOVF       R0+1, 0
	BTFSC      STATUS+0, 0
	ADDLW      1
	ADDWF      _Suma+1, 1
;esclavo.mbas,197 :: 		next Iter
	MOVF       _Iter+0, 0
	XORWF      _Lect_prom+0, 0
	BTFSC      STATUS+0, 2
	GOTO       L__interrupt188
	INCF       _Iter+0, 1
	GOTO       L__interrupt184
L__interrupt188:
;esclavo.mbas,198 :: 		Temp=suma/lect_prom
	MOVF       _Lect_prom+0, 0
	MOVWF      R4+0
	CLRF       R4+1
	MOVF       _Suma+0, 0
	MOVWF      R0+0
	MOVF       _Suma+1, 0
	MOVWF      R0+1
	CALL       _Div_16x16_U+0
	MOVF       R0+0, 0
	MOVWF      _Temp+0
	MOVF       R0+1, 0
	MOVWF      _Temp+1
;esclavo.mbas,199 :: 		Temp2_H=hi(temp)
	MOVF       _Temp+1, 0
	MOVWF      _Temp2_H+0
;esclavo.mbas,200 :: 		Temp2_L=lo(temp)
	MOVF       _Temp+0, 0
	MOVWF      _Temp2_L+0
;esclavo.mbas,201 :: 		if portc.2=0 then
	BTFSC      PORTC+0, 2
	GOTO       L__interrupt190
;esclavo.mbas,202 :: 		Entrada1=1
	MOVLW      1
	MOVWF      _Entrada1+0
	GOTO       L__interrupt191
;esclavo.mbas,203 :: 		else
L__interrupt190:
;esclavo.mbas,204 :: 		Entrada1=0
	CLRF       _Entrada1+0
;esclavo.mbas,205 :: 		end if
L__interrupt191:
;esclavo.mbas,206 :: 		if portc.3=0 then
	BTFSC      PORTC+0, 3
	GOTO       L__interrupt193
;esclavo.mbas,207 :: 		Entrada2=1
	MOVLW      1
	MOVWF      _Entrada2+0
	GOTO       L__interrupt194
;esclavo.mbas,208 :: 		else
L__interrupt193:
;esclavo.mbas,209 :: 		Entrada2=0
	CLRF       _Entrada2+0
;esclavo.mbas,210 :: 		end if
L__interrupt194:
;esclavo.mbas,211 :: 		longitud=94
	MOVLW      94
	MOVWF      _Longitud+0
;esclavo.mbas,212 :: 		Mensaje[0]=0
	CLRF       _Mensaje+0
;esclavo.mbas,213 :: 		mensaje[1]=esclavo
	MOVF       _Esclavo+0, 0
	MOVWF      _Mensaje+1
;esclavo.mbas,214 :: 		Mensaje[2]=temp1_h
	MOVF       _Temp1_H+0, 0
	MOVWF      _Mensaje+2
;esclavo.mbas,215 :: 		Mensaje[3]=temp1_l
	MOVF       _Temp1_L+0, 0
	MOVWF      _Mensaje+3
;esclavo.mbas,216 :: 		Mensaje[4]=temp2_h
	MOVF       _Temp2_H+0, 0
	MOVWF      _Mensaje+4
;esclavo.mbas,217 :: 		Mensaje[5]=temp2_l
	MOVF       _Temp2_L+0, 0
	MOVWF      _Mensaje+5
;esclavo.mbas,218 :: 		Mensaje[6]=entrada1
	MOVF       _Entrada1+0, 0
	MOVWF      _Mensaje+6
;esclavo.mbas,219 :: 		Mensaje[7]=entrada2
	MOVF       _Entrada2+0, 0
	MOVWF      _Mensaje+7
;esclavo.mbas,220 :: 		Mensaje[92]=version_h
	MOVF       _Version_H+0, 0
	MOVWF      _Mensaje+92
;esclavo.mbas,221 :: 		Mensaje[93]=version_l
	MOVF       _Version_L+0, 0
	MOVWF      _Mensaje+93
;esclavo.mbas,222 :: 		calcularcrc
	CALL       _CalcularCRC+0
;esclavo.mbas,223 :: 		portc.4=1
	BSF        PORTC+0, 4
;esclavo.mbas,224 :: 		portc.5=1
	BSF        PORTC+0, 5
;esclavo.mbas,225 :: 		for Iter=0 to longitud   -1
	CLRF       _Iter+0
L__interrupt195:
	DECF       _Longitud+0, 0
	MOVWF      FLOC__interrupt+0
	MOVF       _Iter+0, 0
	SUBWF      FLOC__interrupt+0, 0
	BTFSS      STATUS+0, 0
	GOTO       L__interrupt199
;esclavo.mbas,226 :: 		uart1_write(mensaje[iter])
	MOVF       _Iter+0, 0
	ADDLW      _Mensaje+0
	MOVWF      FSR
	MOVF       INDF+0, 0
	MOVWF      FARG_UART1_Write_data_+0
	CALL       _UART1_Write+0
;esclavo.mbas,227 :: 		next iter
	MOVF       _Iter+0, 0
	XORWF      FLOC__interrupt+0, 0
	BTFSC      STATUS+0, 2
	GOTO       L__interrupt199
	INCF       _Iter+0, 1
	GOTO       L__interrupt195
L__interrupt199:
;esclavo.mbas,228 :: 		uart1_write(crc_l)
	MOVF       _CRC_L+0, 0
	MOVWF      FARG_UART1_Write_data_+0
	CALL       _UART1_Write+0
;esclavo.mbas,229 :: 		uart1_write(crc_h)
	MOVF       _CRC_H+0, 0
	MOVWF      FARG_UART1_Write_data_+0
	CALL       _UART1_Write+0
;esclavo.mbas,230 :: 		delay_ms(3)
	MOVLW      4
	MOVWF      R12+0
	MOVLW      228
	MOVWF      R13+0
L__interrupt200:
	DECFSZ     R13+0, 1
	GOTO       L__interrupt200
	DECFSZ     R12+0, 1
	GOTO       L__interrupt200
	NOP
;esclavo.mbas,231 :: 		if InicioLCD=false then
	MOVF       _InicioLCD+0, 0
	XORLW      0
	BTFSS      STATUS+0, 2
	GOTO       L__interrupt202
;esclavo.mbas,232 :: 		for Iter=0 to 95
	CLRF       _Iter+0
L__interrupt205:
;esclavo.mbas,233 :: 		Mensaje[iter]=32
	MOVF       _Iter+0, 0
	ADDLW      _Mensaje+0
	MOVWF      FSR
	MOVLW      32
	MOVWF      INDF+0
;esclavo.mbas,234 :: 		next Iter
	MOVF       _Iter+0, 0
	XORLW      95
	BTFSC      STATUS+0, 2
	GOTO       L__interrupt208
	INCF       _Iter+0, 1
	GOTO       L__interrupt205
L__interrupt208:
L__interrupt202:
;esclavo.mbas,236 :: 		portc.4=0
	BCF        PORTC+0, 4
;esclavo.mbas,237 :: 		portc.5=0
	BCF        PORTC+0, 5
;esclavo.mbas,238 :: 		porta.5=1                     ' apagar led ambar
	BSF        PORTA+0, 5
L__interrupt177:
;esclavo.mbas,239 :: 		end if
L__interrupt165:
;esclavo.mbas,240 :: 		end if
L__interrupt162:
;esclavo.mbas,241 :: 		end if
L__interrupt159:
;esclavo.mbas,243 :: 		end if
L__interrupt156:
;esclavo.mbas,245 :: 		GIE_bit = 1                   ' enable all interrupts
	BSF        GIE_bit+0, 7
;esclavo.mbas,246 :: 		end sub
L__interrupt221:
	MOVF       ___savePCLATH+0, 0
	MOVWF      PCLATH+0
	SWAPF      ___saveSTATUS+0, 0
	MOVWF      STATUS+0
	SWAPF      R15+0, 1
	SWAPF      R15+0, 0
	RETFIE
; end of _interrupt

_main:

;esclavo.mbas,248 :: 		main:
;esclavo.mbas,249 :: 		option_reg=%11011111
	MOVLW      223
	MOVWF      OPTION_REG+0
;esclavo.mbas,250 :: 		trisa=%00001111
	MOVLW      15
	MOVWF      TRISA+0
;esclavo.mbas,251 :: 		trisb=%11111111
	MOVLW      255
	MOVWF      TRISB+0
;esclavo.mbas,252 :: 		trisc=%10001100
	MOVLW      140
	MOVWF      TRISC+0
;esclavo.mbas,253 :: 		adcon1=%1101
	MOVLW      13
	MOVWF      ADCON1+0
;esclavo.mbas,254 :: 		Version_H=1
	MOVLW      1
	MOVWF      _Version_H+0
;esclavo.mbas,255 :: 		Version_L=27
	MOVLW      27
	MOVWF      _Version_L+0
;esclavo.mbas,256 :: 		Esclavo = eeprom_read(0)
	CLRF       FARG_EEPROM_Read_address+0
	CALL       _EEPROM_Read+0
	MOVF       R0+0, 0
	MOVWF      _Esclavo+0
;esclavo.mbas,257 :: 		LcdStart1 = eeprom_read(1)
	MOVLW      1
	MOVWF      FARG_EEPROM_Read_address+0
	CALL       _EEPROM_Read+0
	MOVF       R0+0, 0
	MOVWF      _LcdStart1+0
;esclavo.mbas,258 :: 		LcdStart2 = eeprom_read(2)
	MOVLW      2
	MOVWF      FARG_EEPROM_Read_address+0
	CALL       _EEPROM_Read+0
	MOVF       R0+0, 0
	MOVWF      _LcdStart2+0
;esclavo.mbas,259 :: 		if LcdStart1 = LcdStart2 then
	MOVF       _LcdStart1+0, 0
	XORWF      R0+0, 0
	BTFSS      STATUS+0, 2
	GOTO       L__main211
;esclavo.mbas,260 :: 		LcdStart1=255
	MOVLW      255
	MOVWF      _LcdStart1+0
;esclavo.mbas,261 :: 		LcdStart2=128
	MOVLW      128
	MOVWF      _LcdStart2+0
L__main211:
;esclavo.mbas,263 :: 		Lect_prom=4
	MOVLW      4
	MOVWF      _Lect_prom+0
;esclavo.mbas,265 :: 		portc.4=0
	BCF        PORTC+0, 4
;esclavo.mbas,266 :: 		portc.5=0
	BCF        PORTC+0, 5
;esclavo.mbas,267 :: 		limpiarleds
	CALL       _LimpiarLeds+0
;esclavo.mbas,268 :: 		uart1_init(9600)
	MOVLW      25
	MOVWF      SPBRG+0
	BSF        TXSTA+0, 2
	CALL       _UART1_Init+0
;esclavo.mbas,269 :: 		RCIE_bit = 1                  ' enable interrupt on UART1 receive
	BSF        RCIE_bit+0, 5
;esclavo.mbas,270 :: 		TXIE_bit = 0                  ' disable interrupt on UART1 transmit
	BCF        TXIE_bit+0, 4
;esclavo.mbas,271 :: 		PEIE_bit = 1                  ' enable peripheral interrupts
	BSF        PEIE_bit+0, 6
;esclavo.mbas,272 :: 		GIE_bit = 1                   ' enable all interrupts
	BSF        GIE_bit+0, 7
;esclavo.mbas,273 :: 		clrwdt
	CLRWDT
;esclavo.mbas,274 :: 		while true
L__main214:
;esclavo.mbas,275 :: 		Leer_LCD
	CALL       _Leer_LCD+0
;esclavo.mbas,276 :: 		inc(LimpiaPerro)
	INCF       _LimpiaPerro+0, 1
;esclavo.mbas,277 :: 		if LimpiaPerro < 40 then
	MOVLW      40
	SUBWF      _LimpiaPerro+0, 0
	BTFSC      STATUS+0, 0
	GOTO       L__main219
;esclavo.mbas,278 :: 		clrwdt
	CLRWDT
L__main219:
;esclavo.mbas,280 :: 		wend
	GOTO       L__main214
	GOTO       $+0
; end of _main
