hhautomatizacion/esclavochallenge/(commit log)

2015-10-14 Commit inicial
    [esclavo.cfg]
2015-10-16 Se actualiza documentacion. Se limpia codigo de programa.
2015-10-18 Se agregar preview de fotos.
2015-10-30 Se agreagan pruebas realizadas con arduino.
2015-11-15 Se agregan diagramas de circuito impreso.
    [Circuito Impreso Esclavo.pcb, Componentes ESCLAVO.xlsx, Diagrama electronico Esclavo.pcb, Lista de componentes por PEDIR LB.xlsx, Lista de componentes por PEDIR.xlsx]
2016-11-10 Se agrega archivo de captura.
2017-02-25 Se reorganizan archivos de acuerdo al estandar.
    [codigo ascii.xls, display secadora 14.csv, display secadora 14.xls]
2018-01-31 Se agregan hojas de datos.
2020-02-06 Se agrega hoja de datos
2020-02-06 Actualizacion de readmes
